moyamartin/pHmeter/Pre-Informe/pre-informe.pdf

Universidad Nacional de Rosario

Facultad de Ciencias Exactas, Ingeniería y Agrimensura

Escuela de Ingeniería Electrónica

## Mediciones Electrónicas

(A-18)

Ingeniería Electrónica

# Introducción al diseño de un medidor de pH

Autores
Nombre y Apellido | Legajo
Martín Moya | M-6132/8
Manuela Rearte | R-2599/2
Lucio Santos | S-4966/2
Ana Paula Soraiz | S-4965/4

Universidad Nacional de Rosario Facultad de Ciencias Exactas, Ingeniería y Agrimensura Escuela de Ingeniería Electrónica

## Índice

1. Introducción | 2
2. Principio de Funcionamiento de la celda Química. | 2
3. Conversión de voltaje a pH | 3
Introducción al diseño de un medidor de pH | Página 1 de 4

Facultad de Ciencias Exactas, Ingeniería y Agrimensura Escuela de Ingeniería Electrónica

## 1. Introducción

Durante el desarrollo de este trabajo se introducirá al lector a las especificaciones del diseño de un medidor de pH y sus futuras aplicaciones dentro de la industra.

A pesar de que el pH es una medida de la concentración de iones de hidrógeno ([H]⁺
) presentes en determinadas disoluciones, el mismo resulta ser de gran importancia dentro de la industria. Mayormente estos dispositivos se implementan en el control de los procesos químicos. Por ejemplo, controlar los niveles de pH en una solución permite asegurar la calidad de un determinado producto, reduce la corrosión y la concentración de sarro en los equipos de una planta, y protege el ambiente ayudando que los desechos al medio se encuentren dentro de los límites regularizados por el estado.

El pH viene definido por la siguiente expresión:

pH = −log -

H⁺
(1)

Sin embargo, a la hora de determinar el valor de pH en una solución se utiliza una celda electroquímica que indica una diferencia de potencial directamente proporcional al valor de pH en la solución.

2. Principio de Funcionamiento de la celda Química.

Como se mencionó anteriormente, el pH es determinado mediante la medición de un voltaje proveniente de una celda electroquímica. Esta celda consiste de:

Un electrodo de medición.

Un electrodo de referencia.

Y, por último, la solución a medir.

El voltaje de la celda es directamente proporcional al valor de pH de la solución. El medidor de pH se encarga de medir el voltaje y usa un factor dependiente de la temperatura para convertir la tensión en un valor de pH.

El voltaje de la celda es una suma algebráfica de los potenciales que la componen, es decir, del electrodo de medición, el electrodo de referencia y la juntura producida por la solución. El electrodo de medición depende exclusivamente del pH en la solución. El potencial de referencia provee una tensión estable de referencia. La juntura de la solución depende de la concentración de iones en la muestra y es originado por un puente salino entre el electrodo de referencia y la solución a medir. Si el sensor es bien diseñado, esta última resulta ser pequeña y constante. Estas tres tensiones dependen fuertemente de la temperatura. En síntesis, se puede observar un diagrama simplificado del sensor de pH en la Figura 1.

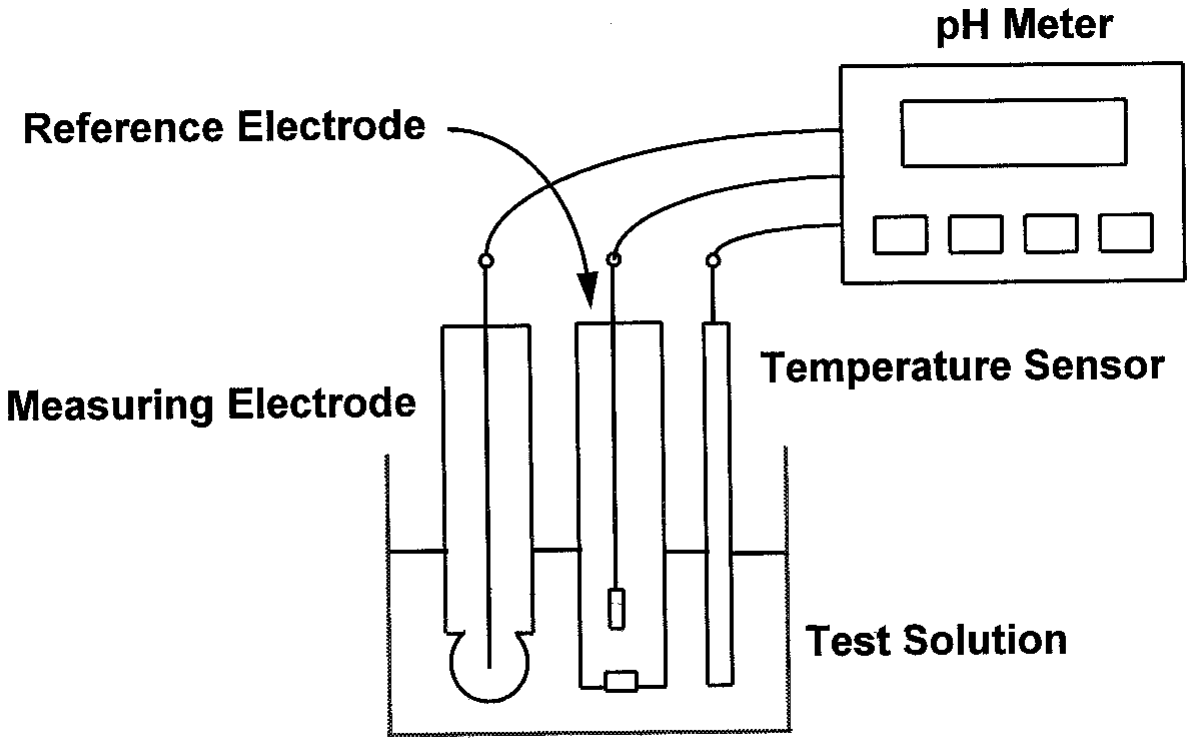
[picture p4: figure]

Figura 1: Esquema simplificado del medidor de pH.

Facultad de Ciencias Exactas, Ingeniería y Agrimensura Escuela de Ingeniería Electrónica

## 3. Conversión de voltaje a pH

La ecuación que relacióna la medición de tensión en la celda (mV), pH y temperatura (Kelvin) está dada por la siguiente expresión:

E(T) = E

- − 0,1984 × T × pH | (2)

Donde E◦
es la suma de:

El potencial correspondiente al electrodo de referencia.

El potencia dentro de la superficie de la membrana de vidrio.

El potencial de referencia externo.

El potencial de la juntura líquida.

El término −0,1984×T ×pH, es el potencial (en mV) fuera de la superficie del vidrio del sensor. Este potencial depende de la temperatura y del pH en la muestra. Asumiendo que la temperatura permanece constante, cualquier cambio en la tensión de la celda está dado por el pH en la muestra. Por lo tanto, el voltaje obtenido de la celda electroquímica es una medida de pH correspondiente a la muestra. La transferencia típica de un celda electroquímica para medición de pH se puede observar en la Figura 2.

0 | 2 | 4 | 6 | 8 | 10 | 12 | 14
pH

-500

-400

-300

-200

-100

0

100

200

300

400

500

Vout [mV]

Función transferencia de una celda electroquímica.

Figura 2: Función transferencia de una celda electroquímica para medir pH.

Teniendo en cuenta esto y que estas celdas tiene una alta impedancia de salida, podemos diseñar un sistema que muestre en display el valor de pH. El sistema de conversión propuesto consiste en tres pasos:

1. Realizar una adaptación de señales, tener en cuenta que la membrana de vidrio causa una resistencia interna de miles de MΩ.
2. Enviar esta señal a un conversor Analógico-Digital, ya sea utilizando un integrado dedicado o implementando uno dentro de un microcontrolador.
3. En caso de ser necesario, realizar una promediación de los valores para mejorar la resolución de la medición y mostrar el resultado en un display.

Facultad de Ciencias Exactas, Ingeniería y Agrimensura Escuela de Ingeniería Electrónica

Por último, se plantean las siguientes especificaciones para el medidor:

Rango de Medición: 0 - 14pH.

Resolución: ±0,1pH.

Rapidez de conversión de 1 palabra/segundo.

Para ello se dispone del microcontrolador Atmega 328p que dispone de un CAD con las siguientes características:

Conversor Analógico Digital de aproximaciones sucesivas.

Resolución de 10 bits.

Tiempo de conversión: 13 - 260 µS˚

7690 Palabras por segundo.

Voltage de entrada: 0 - VCC.

Generación de interrupciones al finalizar una conversión.

Y una celda química diseñada para realizar la medición (Fig. 3)


Figura 3: Celda química para medir pH.
