moyamartin/pHmeter/Informe/phmeter_informe.pdf

Universidad Nacional de Rosario

Facultad de Ciencias Exactas, Ingeniería y Agrimensura

Escuela de Ingeniería Electrónica

## Dinámica de los Sistemas Físicos

(A-12)

Ingeniería Electrónica

## Trabajo Práctico N°3

# Bond-Graph Puente Grúa

Autores
Nombre y Apellido | Legajo
Lucio Santos | S-4966/2
Martín Moya | M-6132/8

Fecha de realización: 9/06/2017 - Fecha de entrega: 16/06/2017

Universidad Nacional de Rosario Facultad de Ciencias Exactas, Ingeniería y Agrimensura Escuela de Ingeniería Electrónica

## Índice

1. Introducción | 2
2. Solución planteada | 3
Puente Grúa | Página 1 de 3

Facultad de Ciencias Exactas, Ingeniería y Agrimensura Escuela de Ingeniería Electrónica

## 1. Introducción

En el siguiente trabajo se presenta el diseño de un medidor de pH destinado específicamente para plantaciones hidropónicas. En el mismo se describirá el desarrollo del producto desde sus primeras etapas hasta la manufactura del mismo, incluyendo una descripción de como calibrar el instrumento y los cuidados que se deben tener al utilizarlo.

La medición de pH consiste en utilizar una celda electroquímica que entrega una fem (Fuerza Electromotriz) proporcional al valor de pH en la solución a medir. La misma consiste de:

Un electrodo de medición.

Un electrodo de referencia.

Y, por último, la solución a medir.

Y la función transferencia de la celda química está dada por la siguiente expresión:

E(T) = E° − 0, 1984 × T × pH

Donde E° es la suma de:

El potencial correspondiente al electrodo de referencia.

El potencial dentro de la superficie de la membrana de vidrio.

El potencial de referencia externo.

El potencial de la juntura líquida.

Considerando que la temperatura es constante (o por lo menos se puede compensar calibrando el instrumento) obtenemos una transferencia lineal. En base a esto, a través de un procesamiento analógico, podemos diseñar un sistema de conversión analógico-digital para mostrar el valor de pH correspondiente a la solución.

Facultad de Ciencias Exactas, Ingeniería y Agrimensura Escuela de Ingeniería Electrónica

## 2. Solución planteada

Para poder obtener una lectura del valor de pH en la solución, se planteó un sistema basado en un Conversor Analógico Digital (CAD) y un sistema de procesamiento analógico para adaptar la señal proveniente de la celda electroquímica a valores aceptables, en los cuales el CAD es capaz de convertir esta señal en un valor digital.

Por último, el valor obtenido por el Conversor Analógico Digital es mostrado en un Display para que el usuario tenga un lectura directa del valor de pH en la solución.

Se plantea administrar el manejo del CAD y el display mediante un microcontrolador de 8 bits debido a que muchos de estos tienen conversores analógicos-digitales integrados y, además, nos permite escalibilizar el sistema en caso de querer aumentar su fucionalidad como por ejemplo, la utilización de protocolos de comunicación con la finalidad de enviar los datos a una computadora o una base de datos.
