moyamartin/pHmeter/Pre-Informe/diagrama-ph.pdf

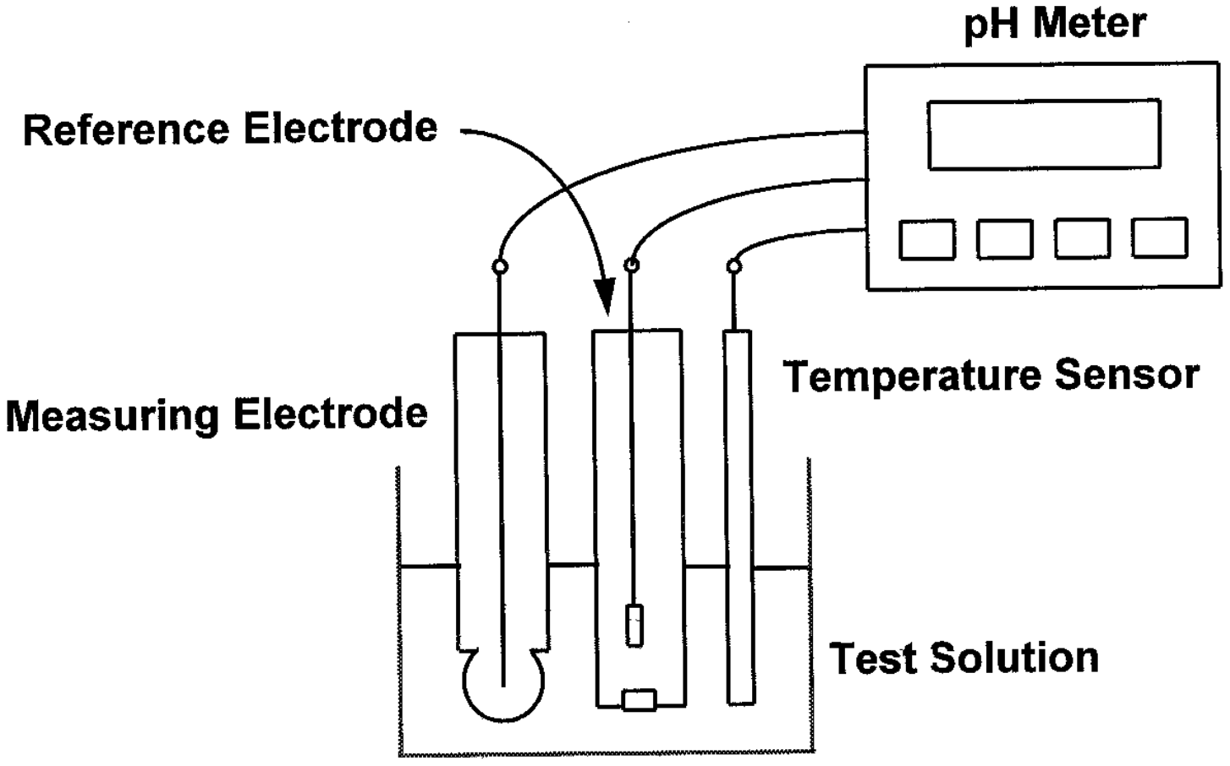
[picture p5: page 1]
