moyamartin/pHmeter/phmeter.pdf

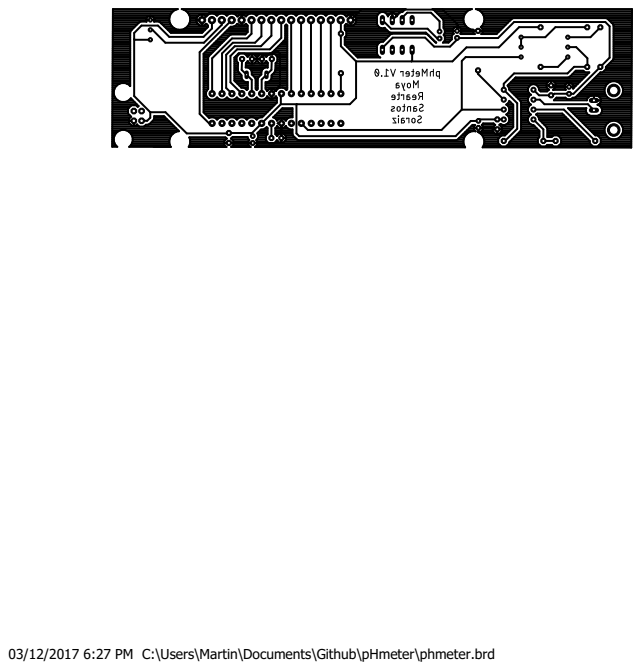
[picture p6: page 1]

03/12/2017 6:27 PM C:\Users\Martin\Documents\Github\pHmeter\phmeter.brd
