moyamartin/pHmeter/(list of files, drawings)

Other design files:
ph-simulaciont.pdsprj
