moyamartin/pHmeter/phmeter.brd

## EAGLE design phmeter.brd (2017-12-02)

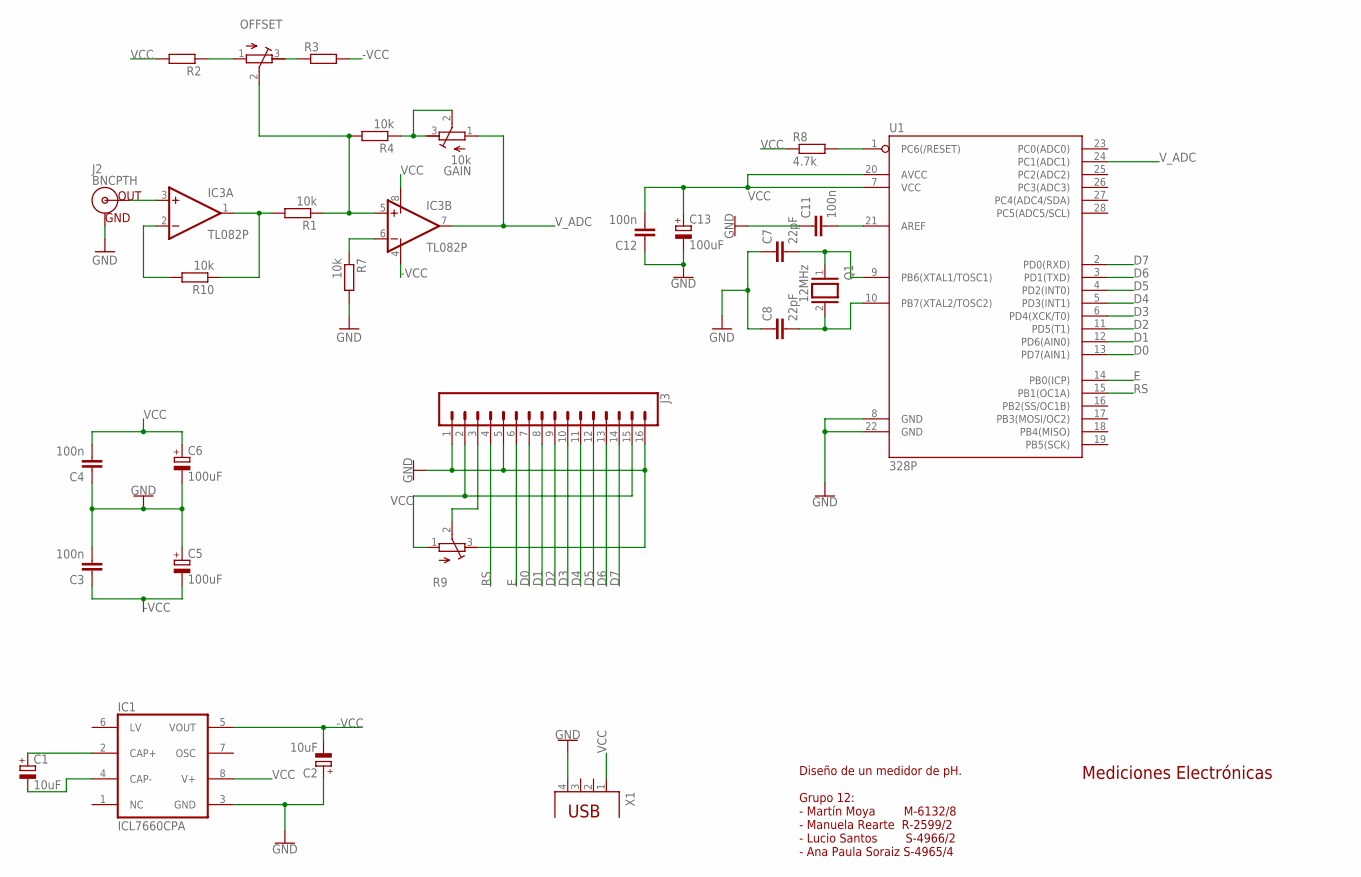
[picture p7: schematic phmeter.sch]

Parts:
C1, C2: 10uF; E1,8-4
C3, C4, C11, C12: 100n; C025-024X044
C5, C6, C13: 100uF; E1,8-4
C7, C8: 22pF; C025-024X044
GAIN: 10k; RTRIM64W
IC1: ICL7660CPA; DIL08
IC3: TL082P; DIL08
J2: BNCPTH; BNC
J3: CONN_16; 1X16
OFFSET: R-TRIMM64W; RTRIM64W
Q1: 12MHz; QS
R1, R4, R7, R10: 10k; 0207/10
R2, R3: R-EU_0207/10; 0207/10
R8: 4.7k; 0207/10
R9: R-TRIMM64W; RTRIM64W
U1: 328P; DIP28
X1: PN61729

Connections:
-VCC: C2.-, C3.1, C5.-, IC1.5 (VOUT), IC3.4 (V-), R3.2
D0: J3.7, U1.13 (PD7(AIN1))
D1: J3.8, U1.12 (PD6(AIN0))
D2: J3.9, U1.11 (PD5(T1))
D3: J3.10, U1.6 (PD4(XCK/T0))
D4: J3.11, U1.5 (PD3(INT1))
D5: J3.12, U1.4 (PD2(INT0))
D6: J3.13, U1.3 (PD1(TXD))
D7: J3.14, U1.2 (PD0(RXD))
E: J3.6, U1.14 (PB0(ICP))
GND: C2.+, C3.2, C4.1, C5.+, C6.-, C7.1, C8.1, C11.1, C12.1, C13.-, IC1.3 (GND), J2.GND, J3.1, J3.5, J3.16, R7.2, R9.3 (E), U1.8 (GND), U1.22 (GND), X1.4
unnamed: IC3.1 (OUT), R1.2, R10.1
unnamed: C1.+, IC1.2 (CAP+)
unnamed: GAIN.2 (S), GAIN.3 (E), R4.1
unnamed: IC3.6 (-IN), R7.1
unnamed: C1.-, IC1.4 (CAP-)
unnamed: OFFSET.3 (E), R3.1
unnamed: OFFSET.1 (A), R2.1
unnamed: C7.2, Q1.1, U1.9 (PB6(XTAL1/TOSC1))
unnamed: C8.2, Q1.2, U1.10 (PB7(XTAL2/TOSC2))
unnamed: J3.3, R9.2 (S)
unnamed: C11.2, U1.21 (AREF)
unnamed: R8.2, U1.1 (PC6(/RESET))
unnamed: IC3.3 (+IN), J2.S (OUT)
unnamed: IC3.2 (-IN), R10.2
RS: J3.4, U1.15 (PB1(OC1A))
VCC: C4.2, C6.+, C12.2, C13.+, IC1.8 (V+), IC3.8 (V+), J3.2, J3.15, R2.2, R8.1, R9.1 (A), U1.7 (VCC), U1.20 (AVCC), X1.1
V_ADC: GAIN.1 (A), IC3.7 (OUT), U1.24 (PC1(ADC1))
V_OFFSET: IC3.5 (+IN), OFFSET.2 (S), R1.1, R4.2

Notes on the sheet:
Diseño de un medidor de pH. Grupo 12: - Martín Moya M-6132/8 - Manuela Rearte R-2599/2 - Lucio Santos S-4966/2 - Ana Paula Soraiz S-4965/4
Mediciones Electrónicas

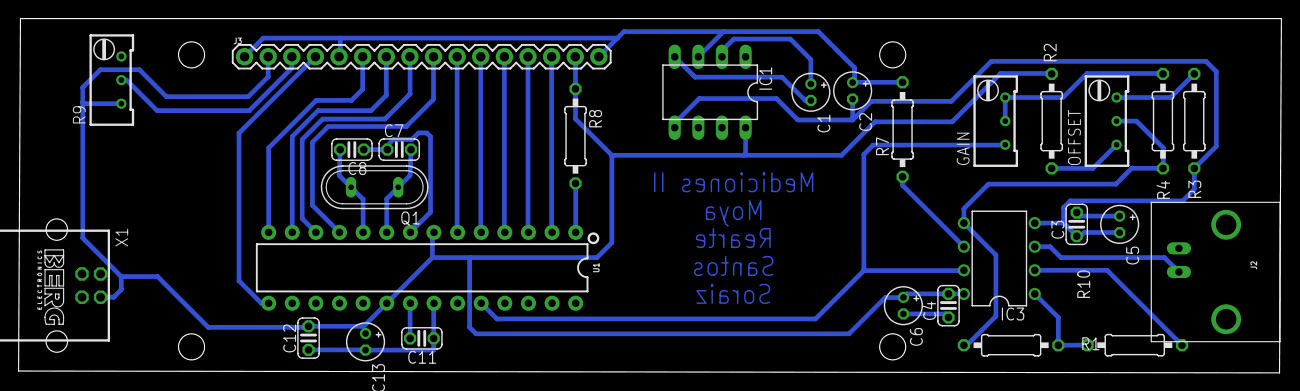
[picture p8: board phmeter.brd from above]

Board: 2 copper layers, 135.8 x 38.1 mm, 28 parts (0 on the bottom side), 29 nets.
