moyamartin/pHmeter/(commit log)

2017-10-22 Started Board Design
    Included FTDI + Atmel328P
    [phmeter.sch]
2017-11-02 Pre-informe, code and simulation
    [ph-simulaciont.pdsprj]
2017-11-30 LCD - ADC Working - updated PCB
    [ph-simulaciont.pdsprj, phmeter.brd, phmeter.sch]
2017-12-01 Ended PCB design
    Generated PCB and it's pdf file. Ready to print.
    [phmeter.brd]
2017-12-02 Finished Board Design
    [phmeter.brd, phmeter.sch]
2017-12-04 Finished board, started documentation.
